Timothy-Chegal/Sound-Activated-LED-Alarm/Pictures/topview.jpeg

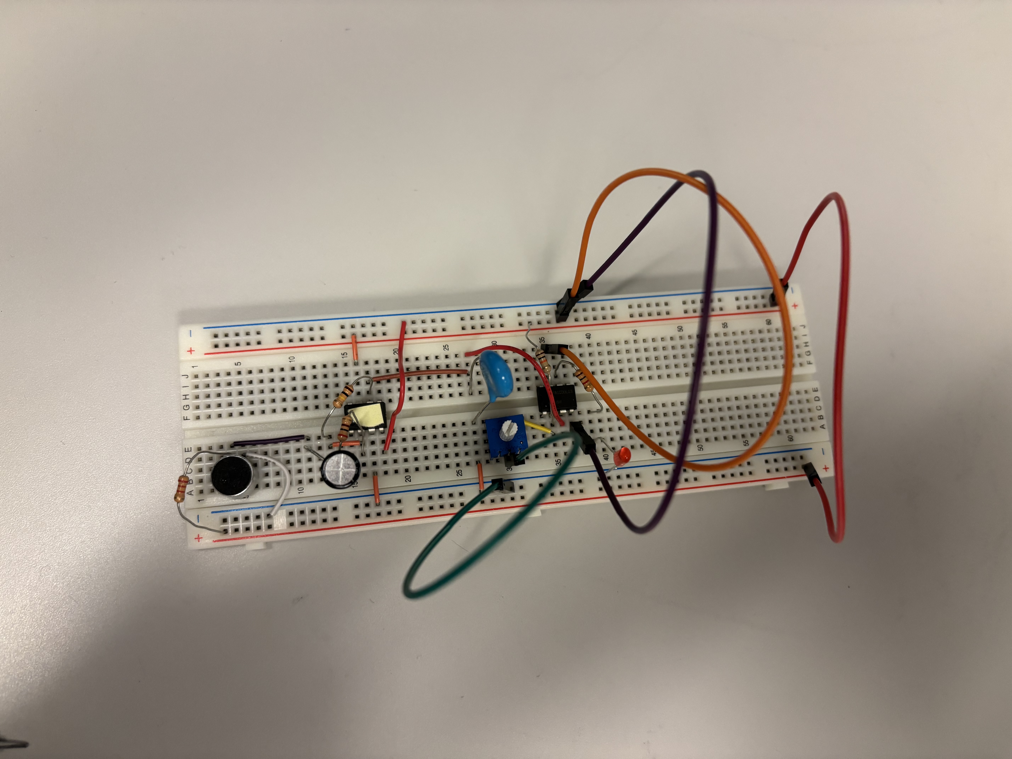
Pictures/topview.jpeg
