Timothy-Chegal/Sound-Activated-LED-Alarm/Pictures/rightview.jpeg

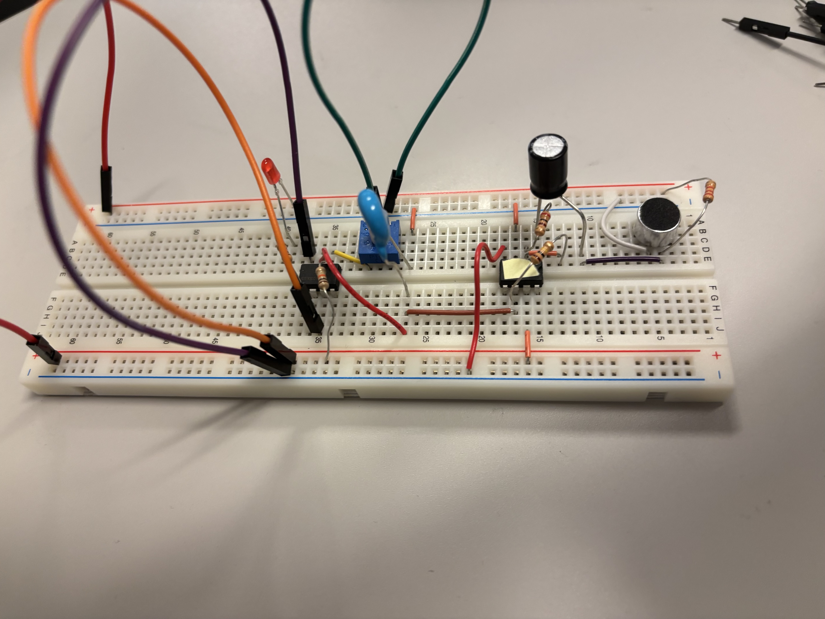
Pictures/rightview.jpeg
