Timothy-Chegal/Sound-Activated-LED-Alarm/README.md

# Sound-Activated-LED-Alarm
An analog sound activated circuit that features hand calculations, LTSpice simulation, and video a demonstration.
Watch Hardware Demo (https://www.youtube.com/watch?v=2BVbXRISIfY)
*(Click above to watch the demonstration video)*
