Timothy-Chegal/Sound-Activated-LED-Alarm/docs/README.md

Folder for lab report, LTSpice waveforms and circuit configuration, CircuitLab schematic, analysis by hand, list of parts, and other references we used.
