Timothy-Chegal/Sound-Activated-LED-Alarm/Pictures/leftview.jpeg

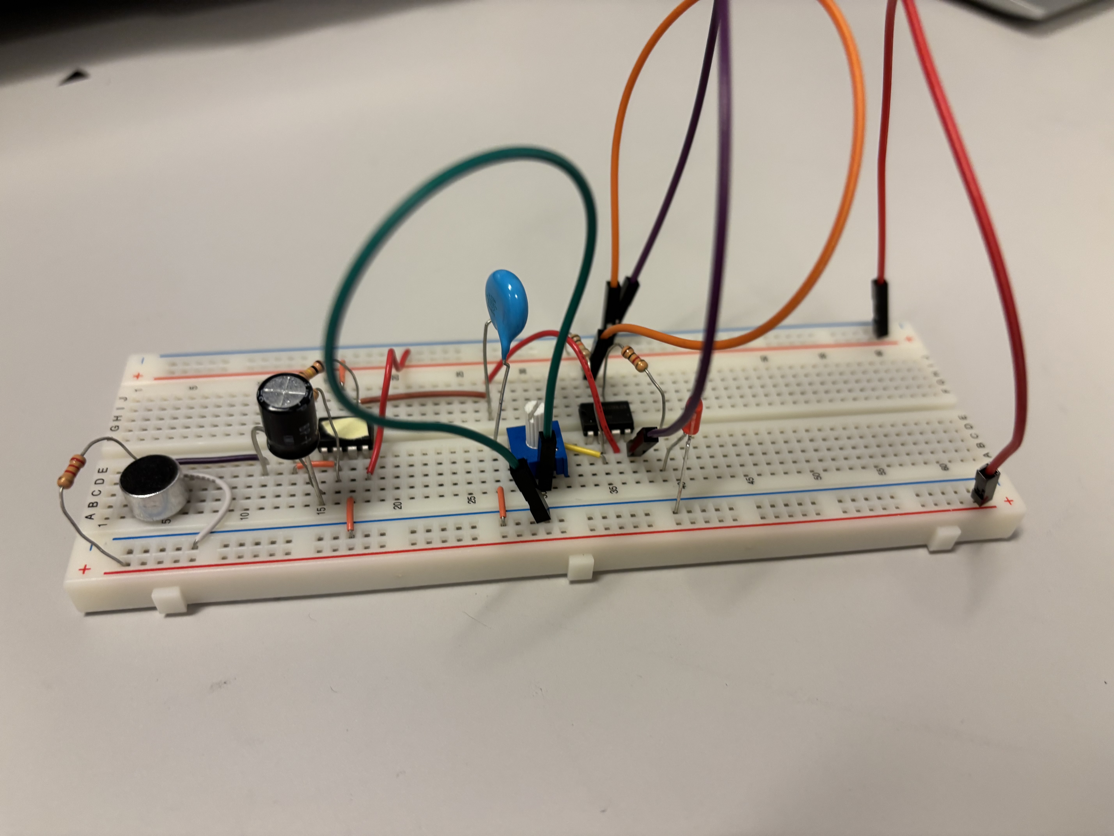
Pictures/leftview.jpeg
