Timothy-Chegal/Sound-Activated-LED-Alarm/Simulation/ECP.asc

C1: cap; 1µ
C2: cap; 4.7n
LED: diode
R1: res; 1k
R3: res; 10k
R4: res; 1k
Rf: res; 100k
Ri: res; 200
U1: UniversalOpAmp2
U2: UniversalOpAmp2
V1: voltage; SINE(0 1 1k)
V2: voltage; 5
V3: voltage; -5
Named nets: 0, Vcc, -Vcc
.tran 0 0.1s 0 1us
